zrlewis/imaging/figures/annotated_schematic.pdf

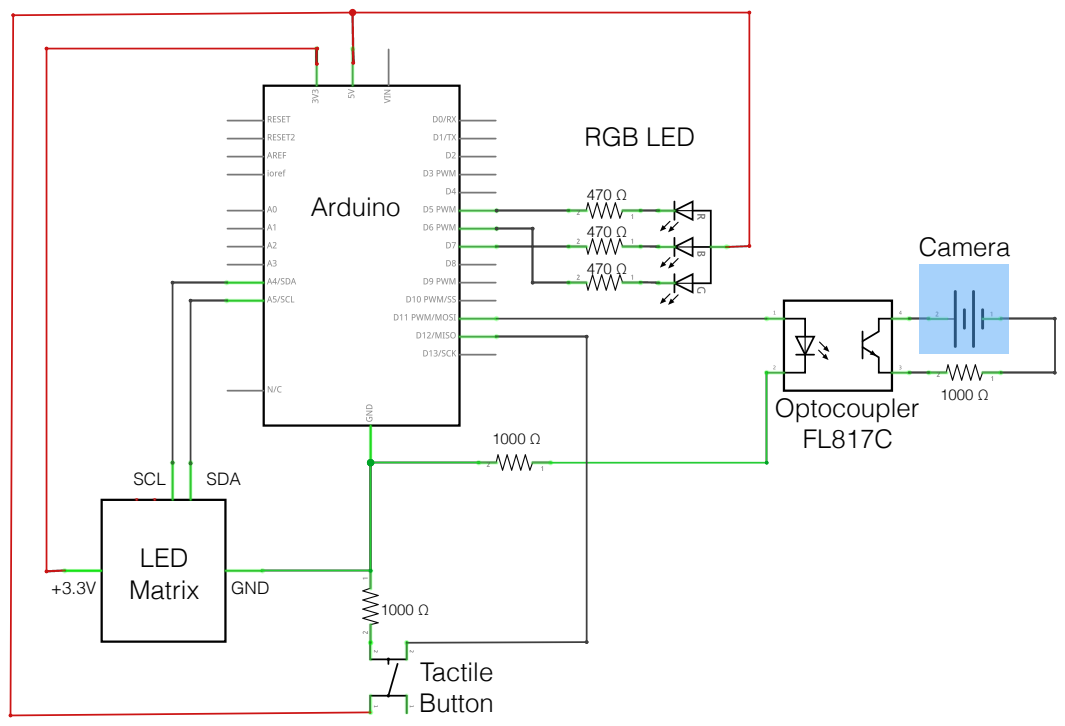
[picture p8: page 1]
LED; Matrix; GND; SCL; SDA; Tactile Button; RGB LED; Optocoupler FL817C; Arduino; Camera
