zrlewis/imaging/(commit log)

2017-05-05 added arduino script
2017-05-06 removed first materials
2017-05-06 switched to gif url
2017-05-06 added image of circuit
2017-05-06 added image of circuit to figures
2017-05-06 added image of circuit to figures html
